AuronWalker/ByteBoy-PCB/CustomLib/74HC151D_653/74HC151D_653.step

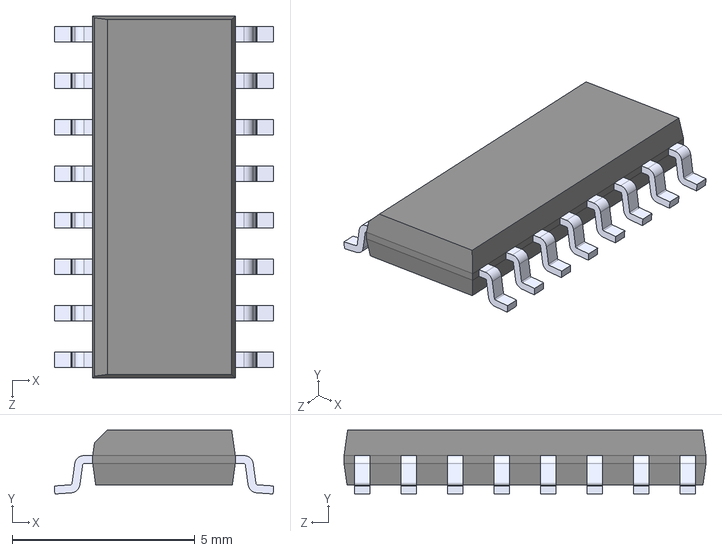
[picture p1: CAD file, 2025-08-14]
CustomLib/74HC151D_653/74HC151D_653.step
6.00 x 1.75 x 9.90 mm
