AuronWalker/ByteBoy-PCB/CustomLib/FT231XS-U/FT231XS-U.step

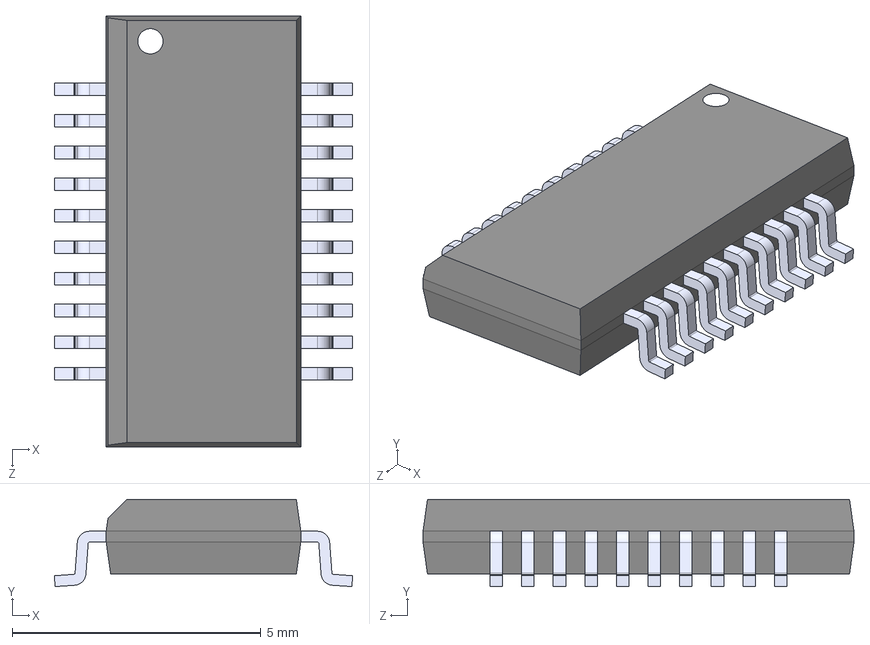
[picture p2: CAD file, 2025-08-13]
CustomLib/FT231XS-U/FT231XS-U.step
5.99 x 1.75 x 8.66 mm
