AuronWalker/ByteBoy-PCB/CustomLib/JS5208/JS5208.step

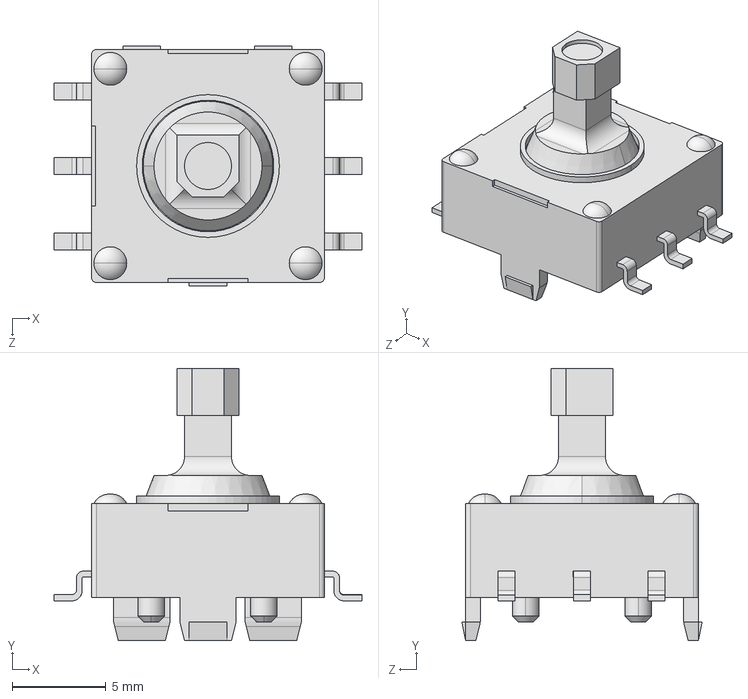
[picture p3: CAD file, 2025-08-07]
CustomLib/JS5208/JS5208.step
16.4 x 14.5 x 12.8 mm
