AuronWalker/ByteBoy-PCB/CustomLib/L-53GD/L-53GD.step

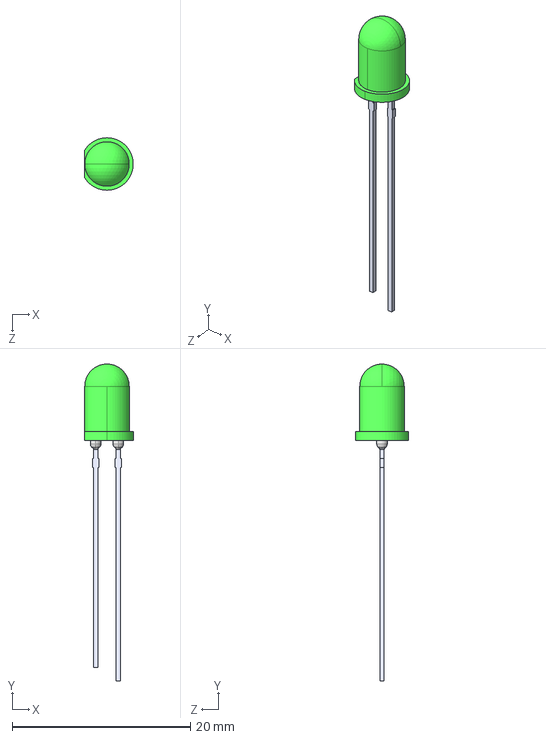
[picture p4: CAD file, 2025-08-17]
CustomLib/L-53GD/L-53GD.step
5.45 x 35.6 x 5.90 mm
