AuronWalker/ByteBoy-PCB/CustomLib/LM1117T-3.3_NOPB/LM1117T-3.3_NOPB.step

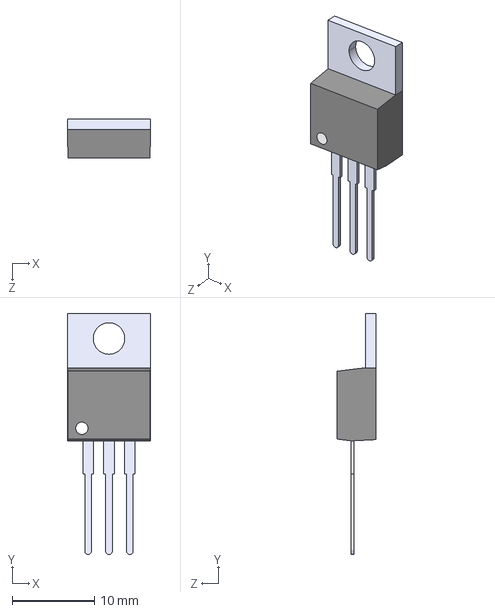
[picture p5: CAD file, 2025-08-07]
CustomLib/LM1117T-3.3_NOPB/LM1117T-3.3_NOPB.step
10.2 x 29.3 x 4.70 mm
