AuronWalker/ByteBoy-PCB/CustomLib/PS1024ALRED/PS1024ALRED.step

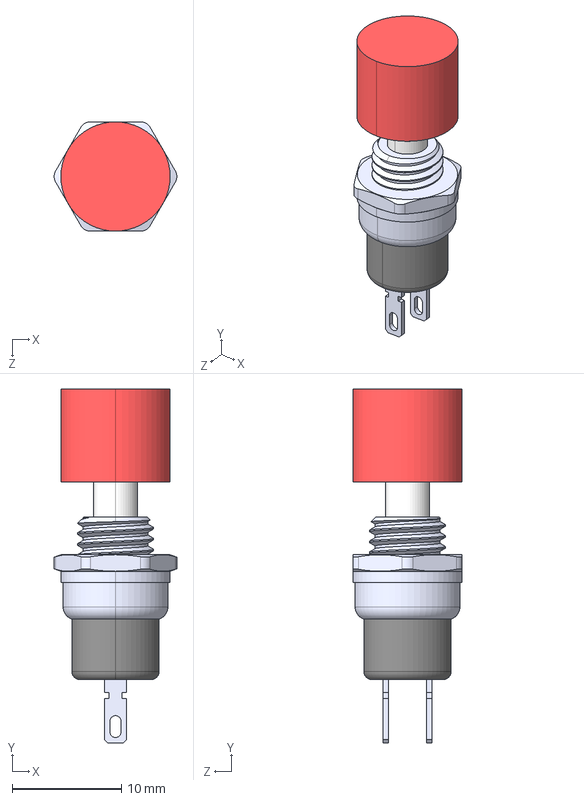
[picture p6: CAD file, 2025-08-07]
CustomLib/PS1024ALRED/PS1024ALRED.step
11.2 x 32.4 x 10.0 mm
