AuronWalker/ByteBoy-PCB/CustomLib/10118194-0001LF/10118194-0001LF.step

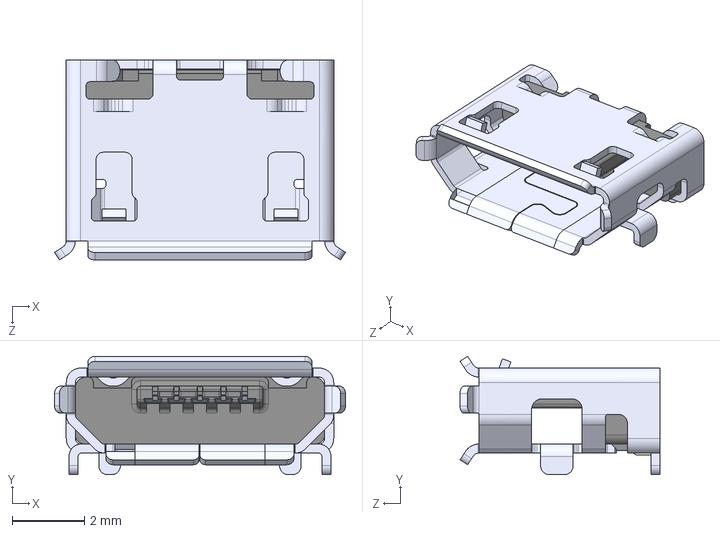
[picture p7: CAD file, 2025-08-07]
CustomLib/10118194-0001LF/10118194-0001LF.step
8.05 x 3.27 x 5.53 mm
