AuronWalker/ByteBoy-PCB/CustomLib/1040310811/1040310811.step

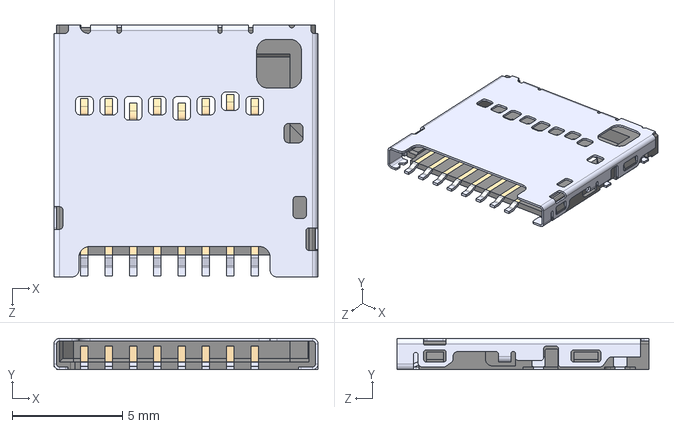
[picture p8: CAD file, 2025-08-07]
CustomLib/1040310811/1040310811.step
12.0 x 1.42 x 11.4 mm
