AuronWalker/ByteBoy-PCB/CustomLib/OS102011MS2QN1/OS102011MS2QN1.step

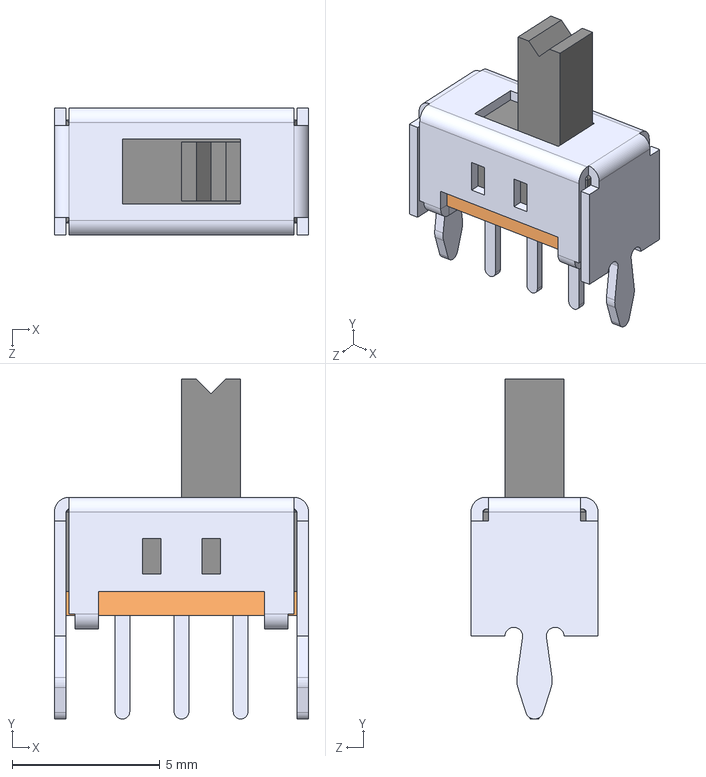
[picture p9: CAD file, 2025-08-13]
CustomLib/OS102011MS2QN1/OS102011MS2QN1.step
8.60 x 11.5 x 4.30 mm
