AuronWalker/ByteBoy-PCB/ByteBoy.kicad_pcb

## KiCad design ByteBoy.kicad_pcb (2025-08-17)

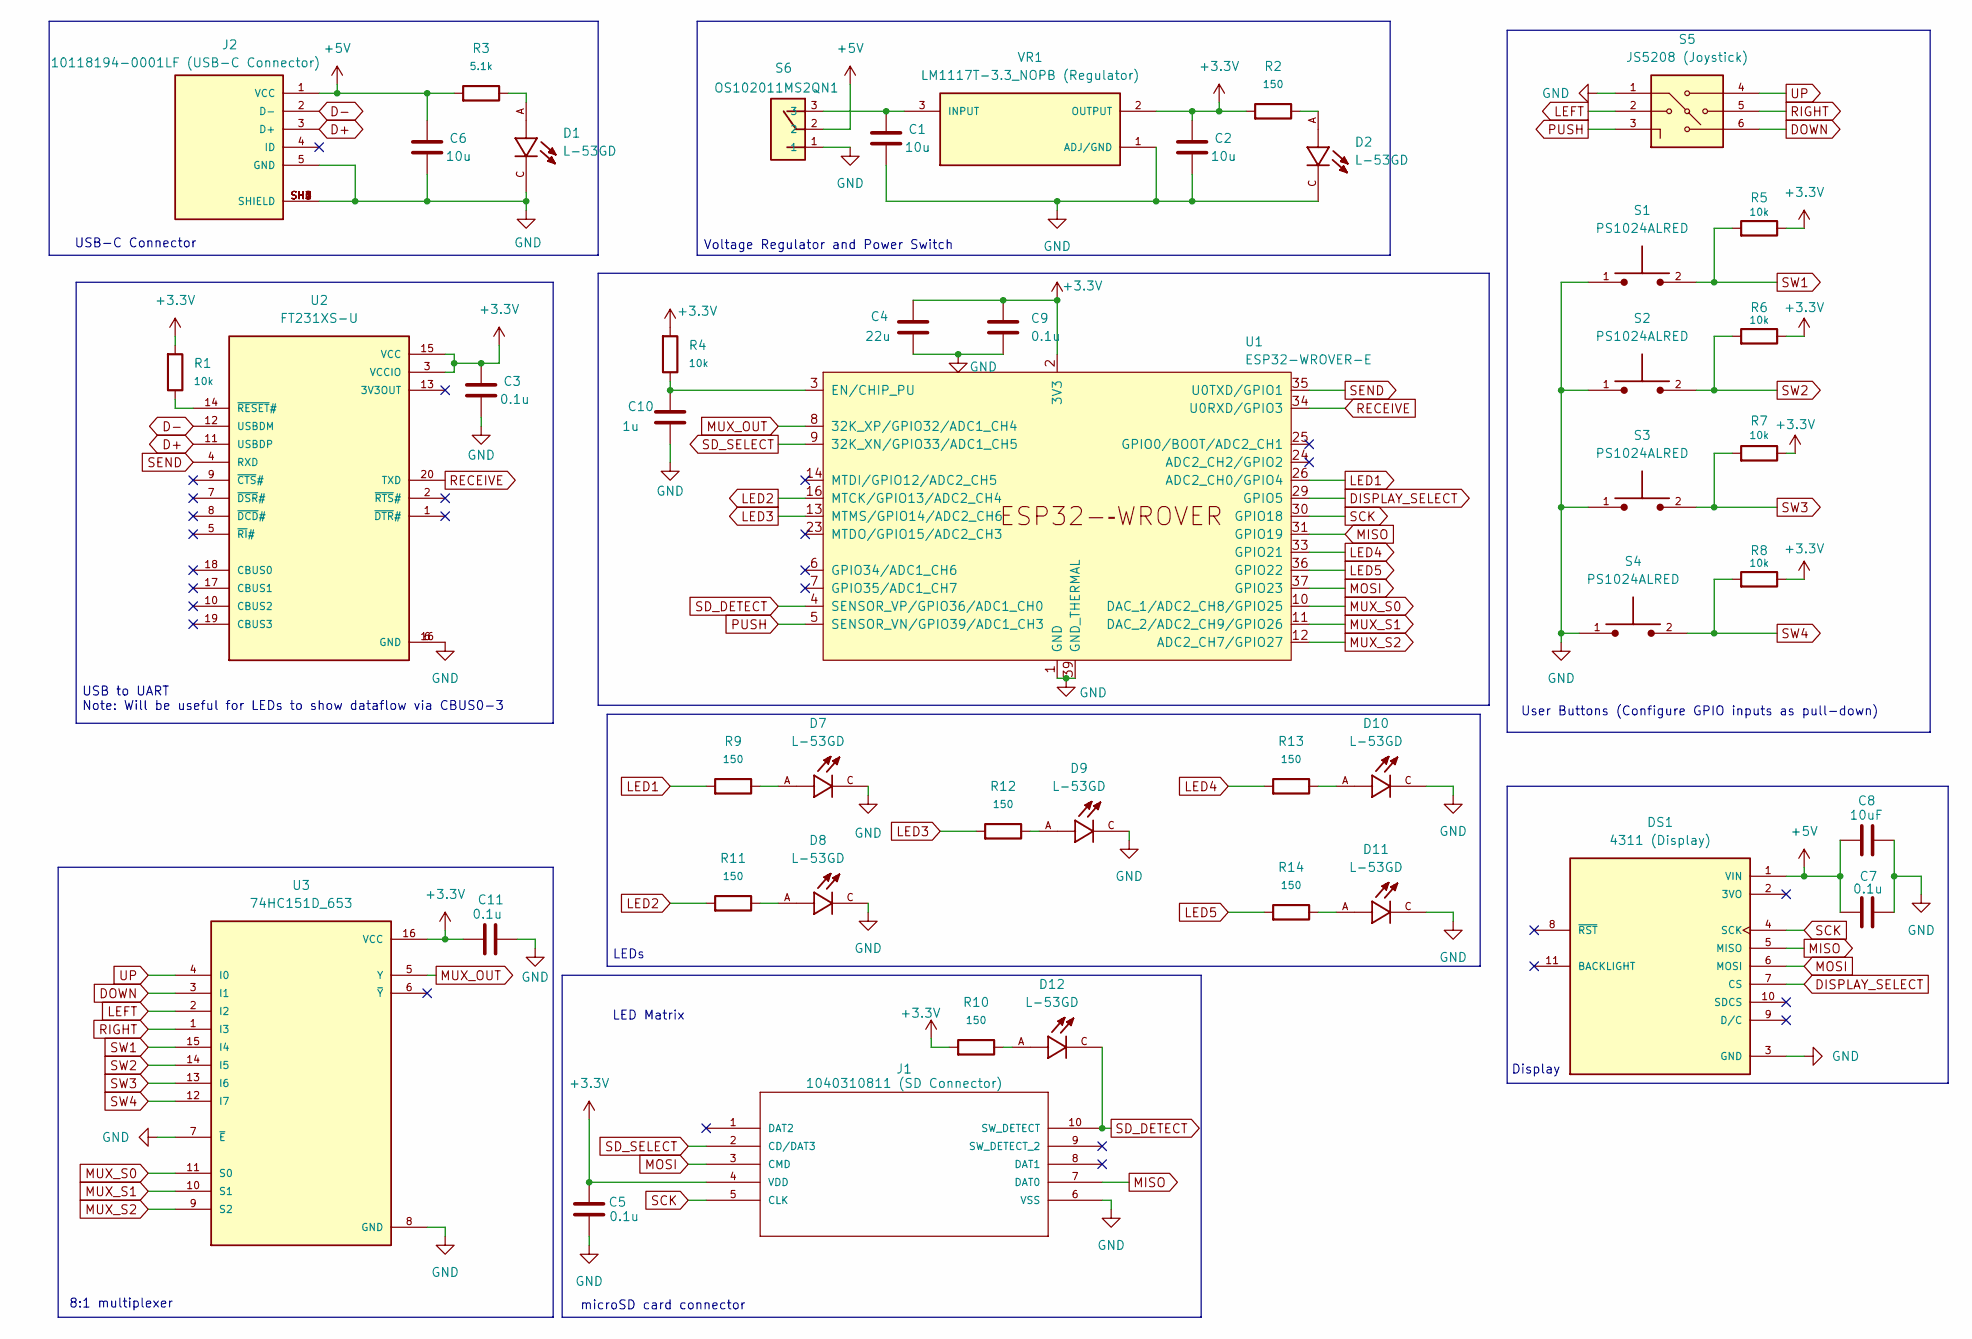
[picture p10: schematic ByteBoy.kicad_sch, Byte Boy]

Parts:
C1, C2, C6: 10u; C_Rect_L7.0mm_W2.5mm_P5.00mm
C3, C5, C7, C9, C11: 0.1u; C_Rect_L7.0mm_W2.5mm_P5.00mm
C4: 22u; C_Rect_L7.0mm_W2.5mm_P5.00mm
C8: 10uF; C_Rect_L7.0mm_W2.5mm_P5.00mm
C10: 1u; C_Rect_L7.0mm_W2.5mm_P5.00mm
D1, D2, D7, D8, D9, D10, D11, D12: L-53GD; LEDRD254W50D500H1060; PARTREV V.3
DS1: 4311 (Display); MODULE_4311; PARTREV 2023-07-05
J1: 1040310811 (SD Connector); 104031-0811_MOL; MANUFACTURER_PART_NUMBER 1040310811
J2: 10118194-0001LF (USB-C Connector); AMPHENOL_10118194-0001LF; PARTREV D
R1, R4, R5, R6, R7, R8: 10k; R_Axial_DIN0207_L6.3mm_D2.5mm_P7.62mm_Horizontal
R2, R9, R10, R11, R12, R13, R14: 150; R_Axial_DIN0207_L6.3mm_D2.5mm_P7.62mm_Horizontal
R3: 5.1k; R_Axial_DIN0207_L6.3mm_D2.5mm_P7.62mm_Horizontal
S1, S2, S3, S4: PS1024ALRED; SW_PS1024ALRED; PARTREV C
S5: JS5208 (Joystick); SW_JS5208; PARTREV D; DigiKey_Part_Number EG4561-ND
S6: OS102011MS2QN1; SW_OS102011MS2QN1
U1: ESP32-WROVER-E
U2: FT231XS-U; SOP63P600X175-20N; PARTREV 1.2
U3: 74HC151D_653; SOIC127P600X175-16N; PARTREV 6; DigiKey_Part_Number 1727-7294-1-ND
VR1: LM1117T-3.3_NOPB (Regulator); TO254P1054X470X1955-3; PARTREV O; DigiKey_Part_Number LM1117T-3.3/NOPB-ND

Connections:
+3.3V: C2.2, C3.2, C4.1, C5.1, C9.1, C11.2, J1.4 (VDD), R1.1, R2.1, R4.1, R5.2, R6.2, R7.2, R8.2, R10.1, U1.2 (3V3), U2.3 (VCCIO), U2.15 (VCC), U3.16 (VCC), VR1.2 (OUTPUT)
+5V: C6.2, C7.1, C8.1, DS1.1 (VIN), J2.1 (VCC), R3.1, S6.2
D+: J2.3 (D+), U2.11 (USBDP)
D-: J2.2 (D-), U2.12 (USBDM)
DISPLAY_SELECT: DS1.7 (CS), U1.29 (GPIO5)
DOWN: S5.6, U3.3 (I1)
GND: C1.1, C2.1, C3.1, C4.2, C5.2, C6.1, C7.2, C8.2, C9.2, C10.2, C11.1, D1.C, D2.C, D7.C, D8.C, D9.C, D10.C, D11.C, DS1.3 (GND), J1.6 (VSS), J2.5 (GND), J2.SH1 (SHIELD), J2.SH2 (SHIELD), J2.SH3 (SHIELD), J2.SH4 (SHIELD), J2.SH5 (SHIELD), J2.SH6 (SHIELD), S1.1, S2.1, S3.1, S4.1, S5.1, S6.1, U1.1 (GND), U1.15 (GND), U1.38 (GND), U1.39 (GND_THERMAL), U2.6 (GND), U2.16 (GND), U3.7 (~E), U3.8 (GND), VR1.1 (ADJ/GND)
LED1: R9.1, U1.26 (ADC2_CH0/GPIO4)
LED2: R11.1, U1.16 (MTCK/GPIO13/ADC2_CH4)
LED3: R12.1, U1.13 (MTMS/GPIO14/ADC2_CH6)
LED4: R13.1, U1.33 (GPIO21)
LED5: R14.1, U1.36 (GPIO22)
LEFT: S5.2, U3.2 (I2)
MISO: DS1.5 (MISO), J1.7 (DAT0), U1.31 (GPIO19)
MOSI: DS1.6 (MOSI), J1.3 (CMD), U1.37 (GPIO23)
MUX_OUT: U1.8 (32K_XP/GPIO32/ADC1_CH4), U3.5 (Y)
MUX_S0: U1.10 (DAC_1/ADC2_CH8/GPIO25), U3.11 (S0)
MUX_S1: U1.11 (DAC_2/ADC2_CH9/GPIO26), U3.10 (S1)
MUX_S2: U1.12 (ADC2_CH7/GPIO27), U3.9 (S2)
unnamed: D1.A, R3.2
unnamed: D2.A, R2.2
unnamed: D7.A, R9.2
unnamed: D8.A, R11.2
unnamed: D9.A, R12.2
unnamed: D10.A, R13.2
unnamed: D11.A, R14.2
unnamed: D12.A, R10.2
unnamed: C10.1, R4.2, U1.3 (EN/CHIP_PU)
unnamed: R1.2, U2.14 (~RESET#)
unnamed: C1.2, S6.3, VR1.3 (INPUT)
PUSH: S5.3, U1.5 (SENSOR_VN/GPIO39/ADC1_CH3)
RECEIVE: U1.34 (U0RXD/GPIO3), U2.20 (TXD)
RIGHT: S5.5, U3.1 (I3)
SCK: DS1.4 (SCK), J1.5 (CLK), U1.30 (GPIO18)
SD_DETECT: D12.C, J1.10 (SW_DETECT), U1.4 (SENSOR_VP/GPIO36/ADC1_CH0)
SD_SELECT: J1.2 (CD/DAT3), U1.9 (32K_XN/GPIO33/ADC1_CH5)
SEND: U1.35 (U0TXD/GPIO1), U2.4 (RXD)
SW1: R5.1, S1.2, U3.15 (I4)
SW2: R6.1, S2.2, U3.14 (I5)
SW3: R7.1, S3.2, U3.13 (I6)
SW4: R8.1, S4.2, U3.12 (I7)
UP: S5.4, U3.4 (I0)

Notes on the sheet:
LEDs
USB-C Connector
microSD card connector
User Buttons (Configure GPIO inputs as pull-down)
USB to UART Note: Will be useful for LEDs to show dataflow via CBUS0-3
LED Matrix
Voltage Regulator and Power Switch
Display
8:1 multiplexer

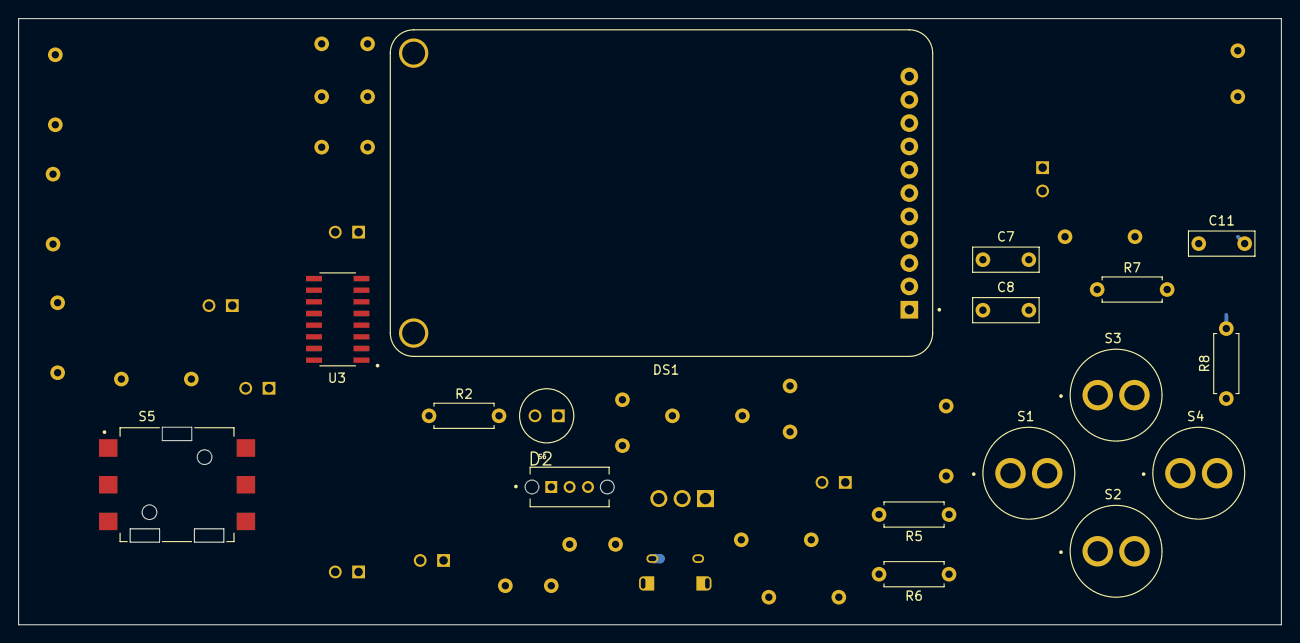
[picture p11: board ByteBoy.kicad_pcb from above]

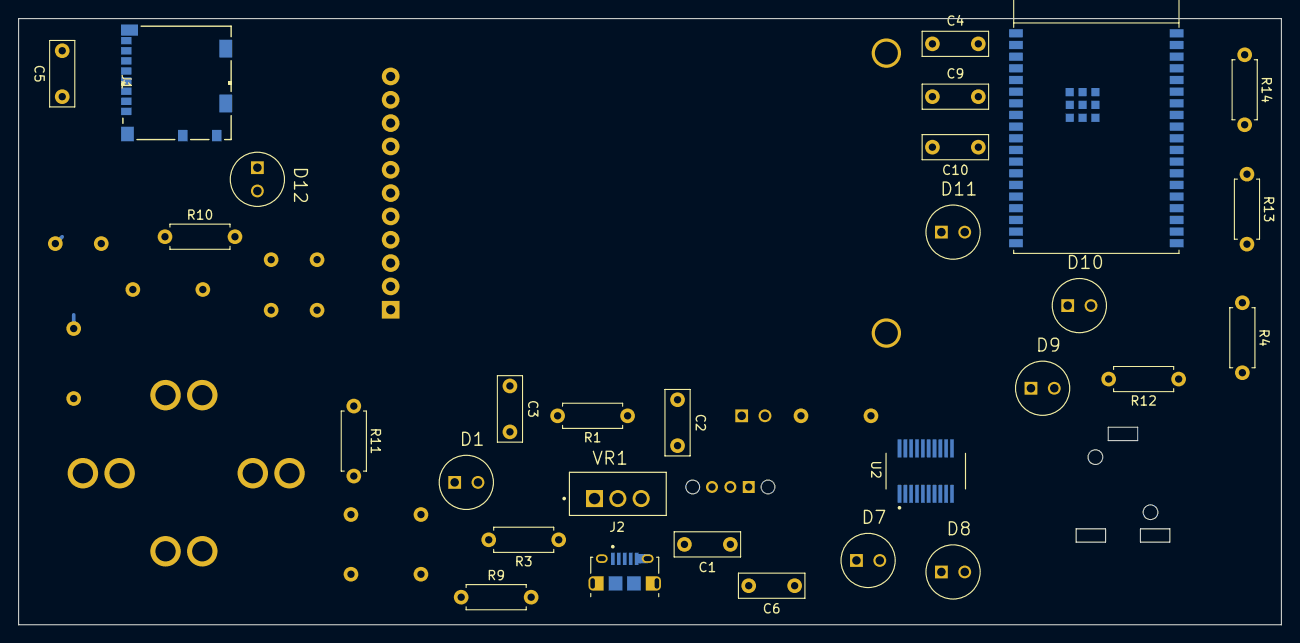
[picture p12: board ByteBoy.kicad_pcb from below]

Board: 2 copper layers, 137.5 x 66.0 mm, 46 parts (29 on the bottom side), 42 nets.
