AuronWalker/ByteBoy-PCB/(commit log)

2025-08-07 Footprints added
    [10118194-0001LF.step, 1040310811.step, ByteBoy.kicad_pcb, ByteBoy.kicad_sch, JS5208.step, LM1117T-3.3_NOPB.step, PS1024ALRED.step]
2025-08-10 Add .gitignore, removed KiCad artifacts
2025-08-13 added usb to uart
    [ByteBoy.kicad_sch, FT231XS-U.step, OS102011MS2QN1.step]
2025-08-14 adding decoupling
    [ByteBoy.kicad_sch]
2025-08-14 schematic done :)
    [74HC151D_653.step, ByteBoy.kicad_sch]
2025-08-17 pcb layout
    [ByteBoy.kicad_pcb, ByteBoy.kicad_sch, L-53GD.step]
